xdylanm/signpost/schematics/prototype_v1.pdf

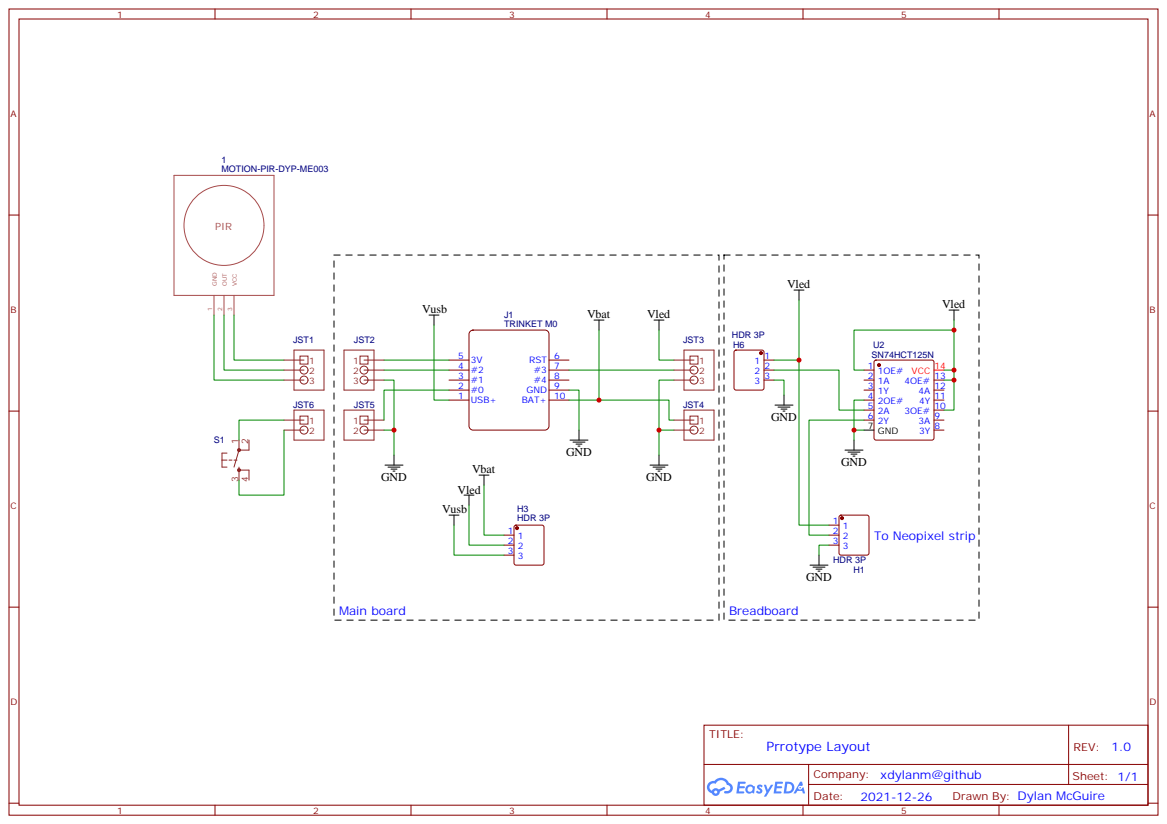
[picture p2: page 1]

Drawn By: Dylan McGuire
