xdylanm/signpost/sketches/signpost/arrowanimation.cpp

#include "arrowanimation.h"

ArrowAnimation::ArrowAnimation(Adafruit_NeoPixel& strip_l, Adafruit_NeoPixel& strip_r) 
  : Animation(strip_l, strip_r), _is_left(true)
{
  set_left_only();
}

void ArrowAnimation::set_both()
{
  _is_left = true;
  set_frame_data(6, 24, &_ani_both[0]);
}

void ArrowAnimation::set_left_only()
{
  _is_left = true;
  set_frame_data(6, 24, &_ani_left[0]);
}

void ArrowAnimation::set_right_only()
{
  _is_left = false;
  set_frame_data(6, 24, &_ani_right[0]);
}

void ArrowAnimation::toggle()
{
  if (_is_left) {
    set_right_only();
  } else {
    set_left_only();
  }
}

int const ArrowAnimation::_ani_left[] = {
  //  0   1   2   3   4   5   6   7   8   9  10  11   
  3,  0,  0,  0,  0,  0,  0,  0,  0,  0,  5,  0,  0,  0,  0,  0,  0,  0,  0,  0,  0,  0,  0,  0,  0,
  4,  0,  5,  0,  0,  5,  5,  0,  0,  5,  5,  5,  0,  0,  0,  0,  0,  0,  0,  0,  0,  0,  0,  0,  0,
  6,  4,  0,  4,  4,  0,  0,  4,  4,  0,  0,  0,  4,  0,  0,  0,  0,  0,  0,  0,  0,  0,  0,  0,  0,
  4,  0,  0,  0,  0,  0,  0,  0,  0,  0,  5,  0,  0,  0,  0,  0,  0,  0,  0,  0,  0,  0,  0,  0,  0,
  60, 0,  5,  0,  0,  5,  5,  0,  0,  5,  5,  5,  0,  0,  0,  0,  0,  0,  0,  0,  0,  0,  0,  0,  0,
  1,  0,  0,  0,  0,  0,  0,  0,  0,  0,  0,  0,  0,  0,  0,  0,  0,  0,  0,  0,  0,  0,  0,  0,  0};

int const ArrowAnimation::_ani_right[] = {
  //  0   1   2   3   4   5   6   7   8   9  10  11   
  3,  0,  0,  0,  0,  0,  0,  0,  0,  0,  0,  0,  0,  0,  0,  0,  0,  0,  0,  0,  0,  0,  5,  0,  0,
  4,  0,  0,  0,  0,  0,  0,  0,  0,  0,  0,  0,  0,  0,  5,  0,  0,  5,  5,  0,  0,  5,  5,  5,  0,
  6,  0,  0,  0,  0,  0,  0,  0,  0,  0,  0,  0,  0,  4,  0,  4,  4,  0,  0,  4,  4,  0,  0,  0,  4,
  4,  0,  0,  0,  0,  0,  0,  0,  0,  0,  0,  0,  0,  0,  0,  0,  0,  0,  0,  0,  0,  0,  5,  0,  0,
  60, 0,  0,  0,  0,  0,  0,  0,  0,  0,  0,  0,  0,  0,  5,  0,  0,  5,  5,  0,  0,  5,  5,  5,  0,
  1,  0,  0,  0,  0,  0,  0,  0,  0,  0,  0,  0,  0,  0,  0,  0,  0,  0,  0,  0,  0,  0,  0,  0,  0};

int const ArrowAnimation::_ani_both[] = {
  //  0   1   2   3   4   5   6   7   8   9  10  11   
  3,  0,  0,  0,  0,  0,  0,  0,  0,  0,  5,  0,  0,  0,  0,  0,  0,  0,  0,  0,  0,  0,  5,  0,  0,
  4,  0,  5,  0,  0,  5,  5,  0,  0,  5,  5,  5,  0,  0,  5,  0,  0,  5,  5,  0,  0,  5,  5,  5,  0,
  6,  4,  0,  4,  4,  0,  0,  4,  4,  0,  0,  0,  4,  4,  0,  4,  4,  0,  0,  4,  4,  0,  0,  0,  4,
  4,  0,  0,  0,  0,  0,  0,  0,  0,  0,  5,  0,  0,  0,  0,  0,  0,  0,  0,  0,  0,  0,  5,  0,  0,
  60, 0,  5,  0,  0,  5,  5,  0,  0,  5,  5,  5,  0,  0,  5,  0,  0,  5,  5,  0,  0,  5,  5,  5,  0,
  1,  0,  0,  0,  0,  0,  0,  0,  0,  0,  0,  0,  0,  0,  0,  0,  0,  0,  0,  0,  0,  0,  0,  0,  0};
