xdylanm/signpost/sketches/signpost/startupanimation.h

#ifndef startupanimation_h_
#define startupanimation_h_

#include "animation.h"

class StartupAnimation : public Animation
{
public:
  StartupAnimation(Adafruit_NeoPixel& strip_l, Adafruit_NeoPixel& strip_r);

private:
  static int const _ani[];
  
};



#endif
