xdylanm/signpost/(commit log)

2021-12-27 initial prototype and tests of functionality
2021-12-31 Added modes and animations for mode selection, tested random and alternating left/right sequences and tested timer driven
2022-01-03 Fixed bug in random bits reset, modified animation for mode
    [ltrtarrowmodeanimation.cpp, signpost.ino]
